LucasPordeus/lucas_gabriel_sistemas_digitais_embarcados/final_project/LINK_DRIVE.md

https://drive.google.com/drive/folders/12veErgy4M6ZnE5FjXudPlkcf83e5Kqnh?usp=sharing

Acesso do Drive liberado para o email: dacio.souza@prof.infnet.edu.br
