LucasPordeus/lucas_gabriel_sistemas_digitais_embarcados/TP3/docs/evidencias/tp3_sim_protocolo_paralelo.txt

VCD info: dumpfile tb_protocolo_paralelo.vcd opened for output.
[OK]    valores padrao de seguranca carregados apos reset
[OK]    comando OP_TEMPO_MIN=20 aplicado corretamente
[OK]    comando OP_LIMIAR_ALTO=15 aplicado corretamente
[OK]    ack em repouso = 0 (pulso de 1 ciclo por comando)
RESULTADO: TODOS OS CASOS PASSARAM (4/4)
tb/tb_protocolo_paralelo.v:72: $finish called at 66000 (1ps)
