LucasPordeus/lucas_gabriel_sistemas_digitais_embarcados/TP5/docs/evidencias/tp5_test_lib_run.txt

[OK] str_len
[OK] uint_to_dec
1234
[OK] cbuf push/pop (FIFO correto)
[OK] gpio_lib (set/read/clear)
