LucasPordeus/lucas_gabriel_sistemas_digitais_embarcados/(commit log)

2026-09-19 Ajustando conexão GPIO Raspberry
2026-09-19 Adicionando guia de montagem de hardware do projeto
2026-09-19 Ajuste de documentação e .cst
2026-09-20 Ajustando lógica do botão do pedestre e tempo de abertura do semáforo
